maciejmatczak/wemos_d1_mini_rgb_matrix/case/dxfs/mid.dxf

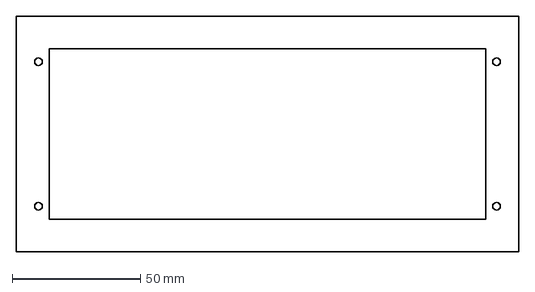
[picture p4: CAD file, 2019-06-09]
case/dxfs/mid.dxf
196.0 x 92.0 mm
