maciejmatczak/wemos_d1_mini_rgb_matrix/case/dxfs/cover.dxf

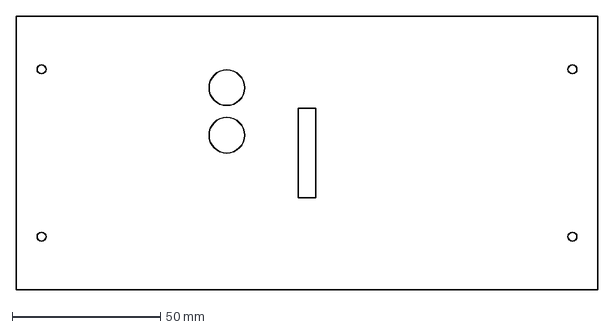
[picture p5: CAD file, 2019-06-09]
case/dxfs/cover.dxf
196.0 x 92.0 mm
