maciejmatczak/wemos_d1_mini_rgb_matrix/case/dxfs/leg.dxf

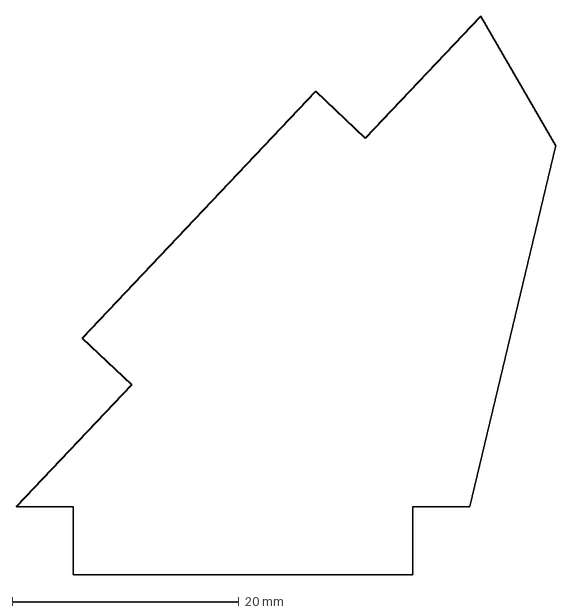
[picture p6: CAD file, 2019-06-09]
case/dxfs/leg.dxf
47.6 x 49.3 mm
