maciejmatczak/wemos_d1_mini_rgb_matrix/(list of files, cad)

Other CAD files:
case/case.f3d
