maciejmatczak/wemos_d1_mini_rgb_matrix/board/wemos_d1_mini_rgb_matrix.kicad_pcb

## KiCad design board/wemos_d1_mini_rgb_matrix.kicad_pcb (2019-05-17)

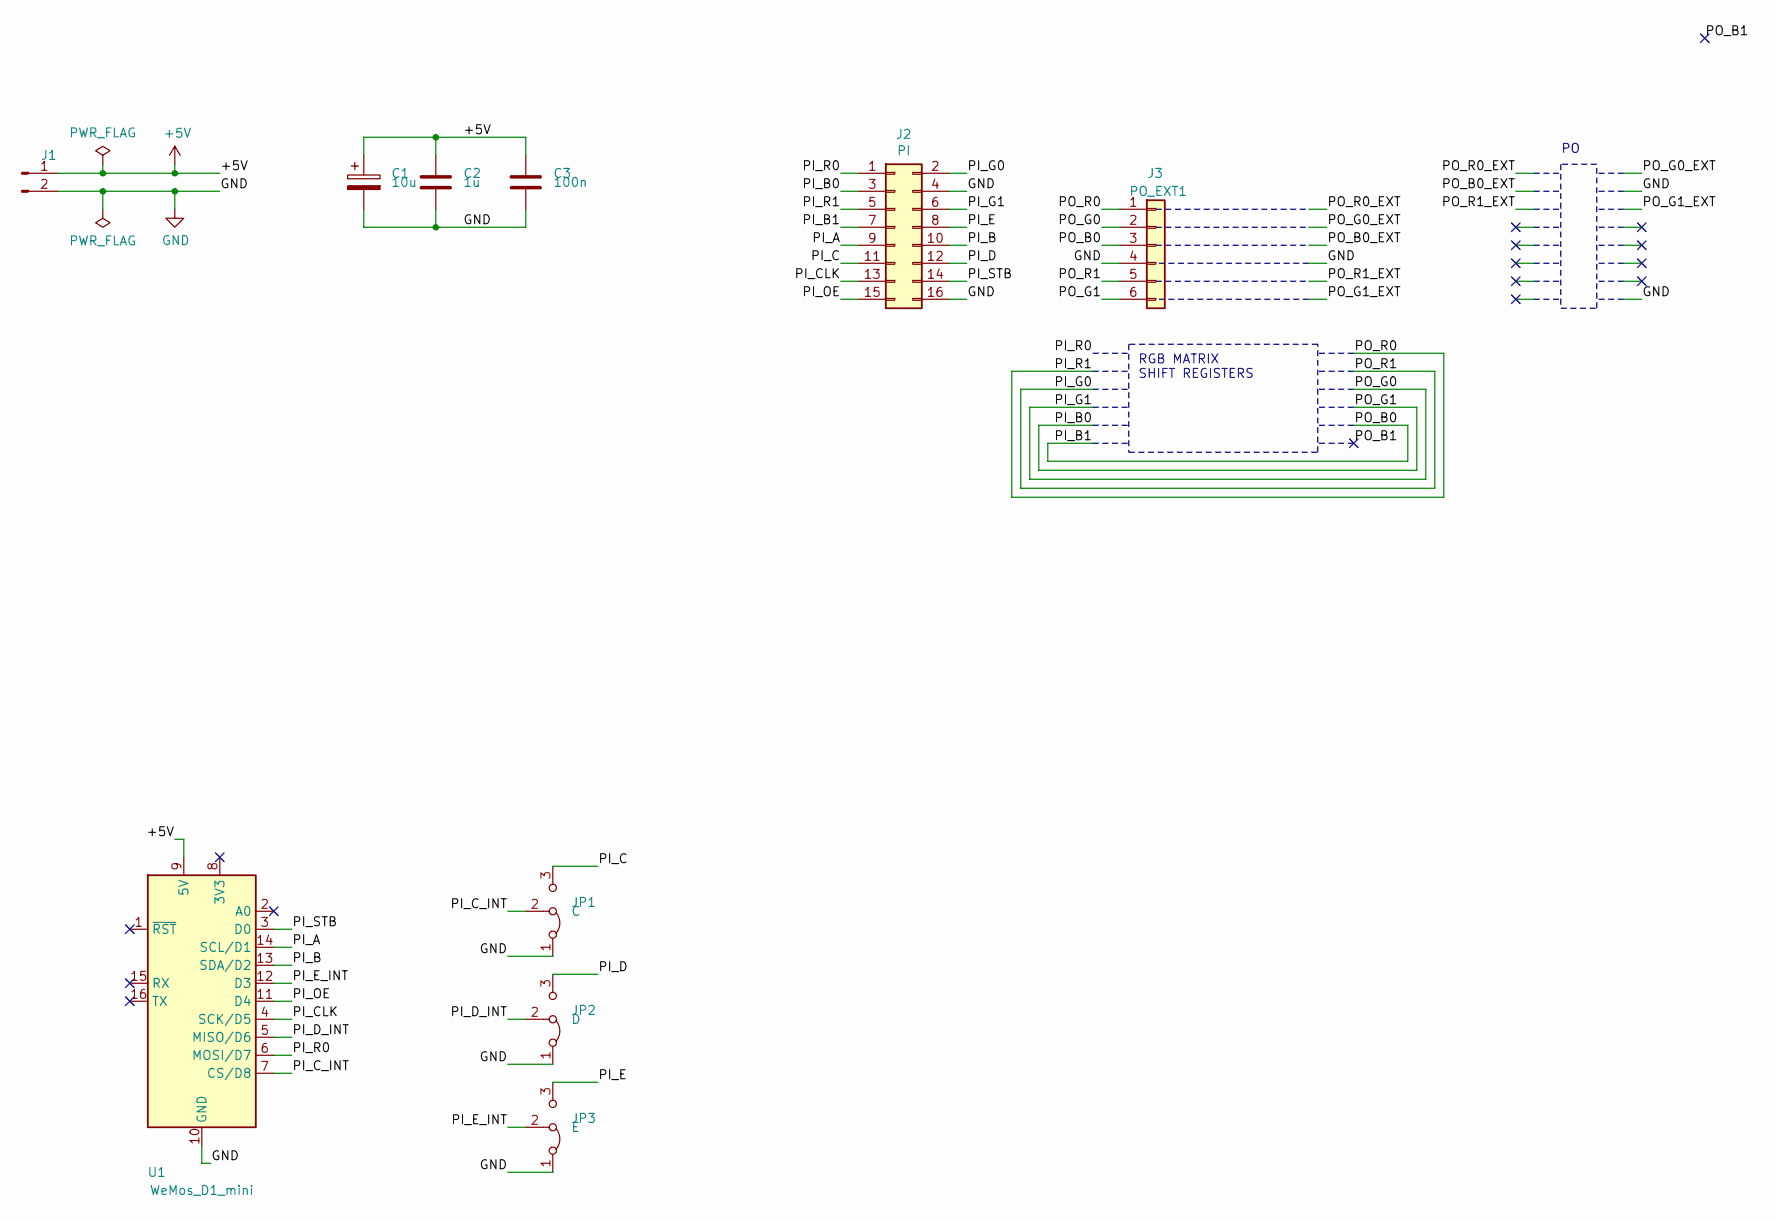
[picture p7: schematic wemos_d1_mini_rgb_matrix.sch]

Parts:
C1: 10u; CP_Radial_D4.0mm_P1.50mm
C2: 1u; C_0805_2012Metric_Pad1.15x1.40mm_HandSolder
C3: 100n; C_0805_2012Metric_Pad1.15x1.40mm_HandSolder
J1: Conn_01x02_Male; SolderWirePad_1x02_P3.81mm_Drill1.2mm
J2: PI; PinSocket_2x08_P2.54mm_Vertical
J3: PO_EXT1; PinHeader_1x06_P2.54mm_Vertical
JP1: C; SolderJumper-3_P1.3mm_Open_Pad1.0x1.5mm
JP2: D; SolderJumper-3_P1.3mm_Open_Pad1.0x1.5mm
JP3: E; SolderJumper-3_P1.3mm_Open_Pad1.0x1.5mm
U1: WeMos_D1_mini; WEMOS_D1_mini_light

Connections:
+5V: C1.1, C2.1, C3.1, J1.1, U1.9 (5V)
/PI_A: J2.9, U1.14 (SCL/D1)
/PI_B: J2.10, U1.13 (SDA/D2)
/PI_B0: J2.3, J3.6
/PI_B1: J2.7, J3.3
/PI_C: J2.11, JP1.3 (B)
/PI_CLK: J2.13, U1.4 (SCK/D5)
/PI_C_INT: JP1.2 (C), U1.7 (CS/D8)
/PI_D: J2.12, JP2.3 (B)
/PI_D_INT: JP2.2 (C), U1.5 (MISO/D6)
/PI_E: J2.8, JP3.3 (B)
/PI_E_INT: JP3.2 (C), U1.12 (D3)
/PI_G0: J2.2, J3.5
/PI_G1: J2.6, J3.2
/PI_OE: J2.15, U1.11 (D4)
/PI_R0: J2.1, U1.6 (MOSI/D7)
/PI_R1: J2.5, J3.1
/PI_STB: J2.14, U1.3 (D0)
GND: C1.2, C2.2, C3.2, J1.2, J2.4, J2.16, J3.4, JP1.1 (A), JP2.1 (A), JP3.1 (A), U1.10 (GND)

Notes on the sheet:
RGB MATRIX SHIFT REGISTERS

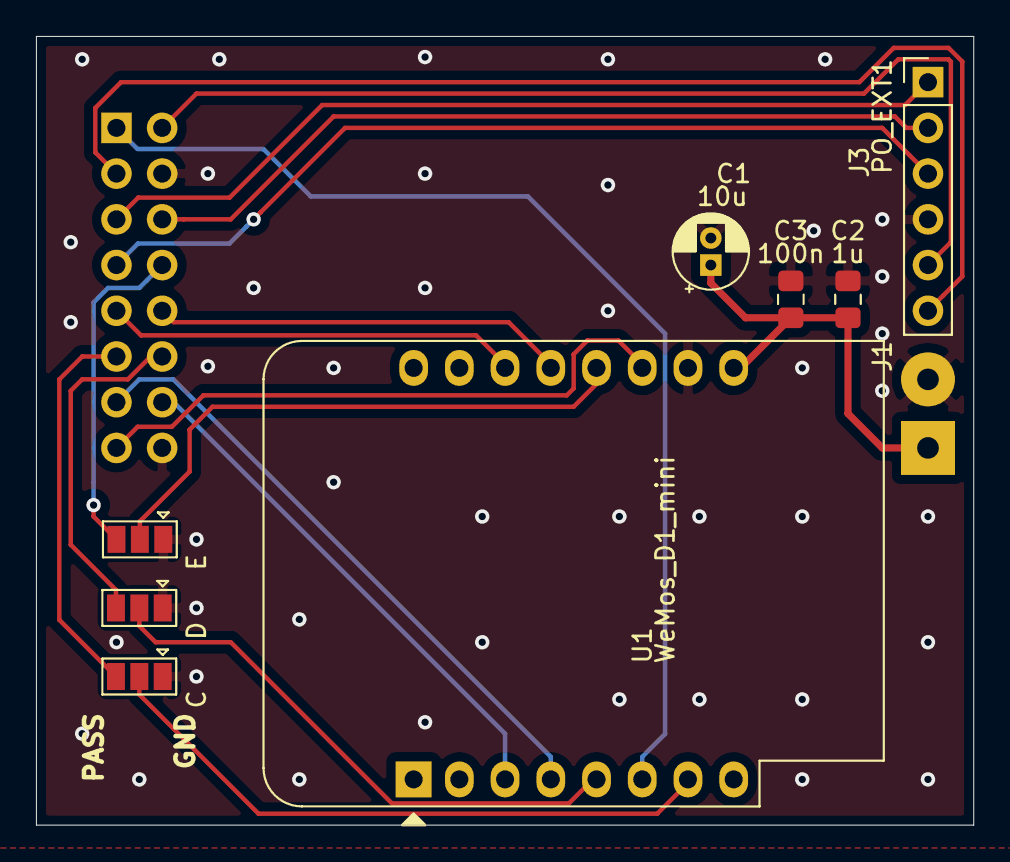
[picture p8: board wemos_d1_mini_rgb_matrix.kicad_pcb from above]

Board: 2 copper layers, 52.1 x 43.8 mm, 10 parts (1 on the bottom side), 19 nets.
