maciejmatczak/wemos_d1_mini_rgb_matrix/(commit log)

2019-05-17 Adding board files on first design iteration
    [wemos_d1_mini_rgb_matrix.kicad_pcb, wemos_d1_mini_rgb_matrix.sch]
2019-05-17 Add plot script for KiCAD
2019-06-09 Trying out FreeCAD way
    [case.FCStd]
2019-06-09 Move to Fusion 360 design
    [case.FCStd]
2019-06-09 Add F360 model files, images and description
    [case.f3d, cover.dxf, leg.dxf, mid.dxf]
